Rudraksh91/SatelliteSoilMonitoring/ndvi_latest.jpeg

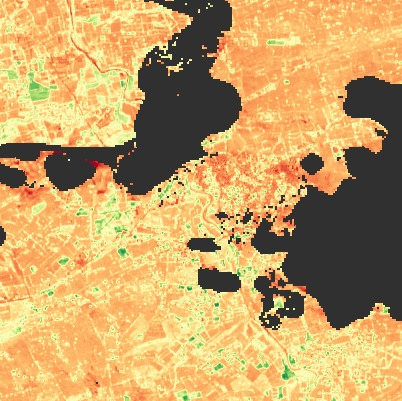
ndvi_latest.jpeg
