Rudraksh91/SatelliteSoilMonitoring/AgriSat_Flowchart.pdf

# ️ AgriSat Dediapada — System Architecture

# Satellite-Driven Autonomous Irrigation · Dediapada, Narmada, Gujarat

👥 ANY DEVICE — ANYWHERE

⚙️ macOS AUTOMATION

🌐 NETWORK / HOSTING

💾 STORAGE

🧠 app.py — Streamlit (port 8501)

📡 DATA SOURCES

Irrigation Decision Engine

Dashboard UI — 4 Tabs

ET₀ · Rain · Temp · Humidity | VWC % (SAR-derived)
No | Yes → irrigate
Every 30 min | Every 30 min

Auto-push rows

New URL on restart REST API PUT

Monitors

kickstart -k on failure

302 redirect | 302 redirect | 302 redirect

Served on :8501

Executes

Starts

Starts

Monitors

📱 Phone | 📟 Tablet | 💻 Browser

📜 run_agrisat.sh

Kill old processes cleanup trap on EXIT

Start Streamlit Wait for :8501

Start cloudflared Wait for tunnel URL | Wait 6s for stability Update Worker via REST API Save .tunnel_url + .permanent_url

🔄 launchd
com.agrisat.dediapada RunAtLoad · KeepAlive ThrottleInterval 15s Runs run_agrisat.sh

🩺 Daily Health Check
com.agrisat.healthcheck 9 AM every day 7 checks · Auto-restart on fail Mac notification on issue

☁️ Cloudflare Quick Tunnel cloudflared binary Random trycloudflare.com URL Changes on every restart

🔗 Cloudflare Worker Permanent URL agrisat-dediapada

.rudrakshpatel91.workers.dev 302 redirect → tunnel URL

📄 telemetry_log.csv Local file · Every 30 min All 3 fields per entry

📊 Google Sheets Auto-sync via Service Account agrisat-logger@…

Auto tab rotation at 50k rows

🏠 Dashboard
3 field cards · KPI gauge
Folium map · Radar chart | 📊 Live Data VWC trend · Charts Telemetry table · CSV download | ️ Data Sources Bhoonidhi auth Google Drive sync | ⚙️ Settings Crop · Area · Valve override
| | | Soil parameters

Soil VWC %
Satellite → Estimated fallback

VWC < 23%
refill point? Rain guard?

✅ Open Valve Duration = deficit ÷ drip rate ÷ efficiency Voice alert via speechSynthesis ⏸ Hold Valve Reason logged

️ ISRO EOS-04 SAR
Bhoonidhi API Soil Moisture VWC %

500m resolution · 6h cache

️ Open-Meteo API Temperature · Humidity Rainfall · ET₀ FAO-56

Free · No API key

02/06/2026, 09:49 | AgriSat — System Flowchart
file:///Users/rudrakshpatel/Desktop/SatelliteSoilMonitoring/flowchart.html | 1/1
