Rudraksh91/SatelliteSoilMonitoring/(commit log)

2026-06-08 TERRA-CORE AgriSat — initial deploy
    Satellite soil monitoring & smart irrigation dashboard.
    - Streamlit dashboard with NDVI, valve control, telemetry
    - ESP32 + LoRa field node firmware
    - Raspberry Pi brain (NDVI + AI decisions)
    - MQTT cloud bridge (HiveMQ)
    - PWA + Capacitor mobile app
2026-06-08 Add remaining project assets — docs, scripts, imported screens
2026-06-08 Add .nojekyll — disable Jekyll for GitHub Pages static deploy
2026-06-08 Fix PWA home-screen 404 — set correct GitHub Pages subpath in manifest + sw.js
    start_url and scope were "/" causing 404 when opened from home screen.
    Updated to "/SatelliteSoilMonitoring/" for GitHub Pages deployment.
    Bumped SW cache version to v1.1 to force old SW to update.
    [sw.js]
2026-06-09 fix: bump SW cache to v1.2 + switch HTML to network-first strategy
    Old cache-first strategy was serving the pre-Sentinel-1 index.html from
    agrisat-app-v1.1 on Mac browsers that had the SW installed, while phones
    without the cached SW fetched fresh from the network.
    Fix:
    - Bump APP_CACHE / CDN_CACHE to v1.2 (activate event nukes the v1.1 cache)
    - HTML navigation requests now use network-first so future deploys appear
    immediately without requiring another cache version bump
    - Static assets (icons, manifest) stay on cache-first for offline speed
    [sw.js]
2026-06-10 design: comprehensive UI refresh for TERRA-CORE AgriSat dashboard
    - Radial gradient body background (green + cyan ambient glows)
    - Glassmorphism .gp cards: gradient fill, depth shadow, hover lift
    - Upgraded header: gradient + strong backdrop-blur + green glow border
    - Upgraded sidebar: gradient fill, glowing eco logo icon, section divider
    - Upgraded footer: gradient fill, live status dot, consistent typography
    - nav-btn cursor:pointer + active green gradient + inset left border
    - KPI glow utilities (green/cyan/amber) applied to all key metrics
    - LIVE pill: rounded-full green-tinted + glowing dot indicator
    - 3px slim scrollbar with transparent track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
2026-06-10 design: round all card corners to 16px
    - .gp: border-radius 16px !important + overflow hidden (clips content to rounded shape)
    - Tailwind borderRadius scale bumped: DEFAULT→12px, lg→16px, xl→20px, 2xl→24px
    so every rounded / rounded-lg / rounded-xl utility class is also soft now
2026-06-10 feat: satellite loading screen after setup screen button tap
    - Animated SVG scene: Earth radar node with rotating sweep, 3 expanding
    signal rings, elliptical orbit with a detailed satellite (body + dual
    solar panels + blinking antenna + data-packet beam toward earth)
    - HUD overlays: corner brackets, ALT/INC/SAR/MODE data left, NDVI/SWATH/
    PASS/RES data right, signal-strength bars, satellite attribution footer
    - Smooth 3-second progress bar (rAF loop) + 6 cycling status messages
    (INITIALIZING → SATELLITE HANDSHAKE → NDVI STREAM → WEATHER → SENSORS → NOMINAL)
    - Both setup paths hooked: setupConnect success and setupSkip both call
    showSatLoader(); dashboard initialises in th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
2026-06-10 data: NDVI update 2026-06-10 — all zones STRESSED
    Auto-harvested by NDVIHarvester v2 at 11:29 IST.
    Sentinel-2 scene: 2026-05-26, cloud cover 1.1%.
    New Drive JPEG ID: 124jmxVN8sr8SSKMpwRketyVUlXRaDdMN
    Weather: ET0=2.39mm/d Rain3d=2.2mm VPD=0.68kPa
2026-06-10 feat: realistic Earth globe + detailed satellite in loading screen
    - Globe: deep ocean gradient, rotating continents (Africa, India, Asia,
    Europe, Americas, Antarctica, cloud streaks), lat/lon grid, atmosphere
    edge glow, night-side shadow, specular highlight
    - Satellite: gold thermal-blanket body with seam lines, multi-cell solar
    panels with gradients and grid lines, imaging aperture, star tracker,
    S-band dish, high-gain antenna boom, blinking LEDs, nadir signal beam
2026-06-10 Replace misleading "ACTIVE SENSORS: 6" with "SAR SATELLITES: 2"
    Project has zero ground sensors — soil data comes entirely from
    EOS-04 SAR and Sentinel-1 SAR imagery. Updated KPI card on the
    map page to accurately reflect the two satellite data sources.
2026-06-10 Fix crop dropdown clipped by overflow-hidden on valve cards
    Switched .crop-drop from position:absolute to position:fixed so it
    escapes the overflow:hidden on the valve zone cards. showCropDrop()
    now reads getBoundingClientRect() on the input and pins the dropdown
    to the exact screen coordinates, making the full list visible.
2026-06-10 Fix crop dropdown position — teleport to body to escape backdrop-filter
    backdrop-filter on .gp cards creates a new fixed-position containing
    block in Chromium, so position:fixed was offset by the card's position.
    Fix: on showCropDrop(), move the dropdown to <body> (via appendChild)
    so it is a direct child of the root and position:absolute with
    getBoundingClientRect()+scrollY gives the correct viewport coordinates,
    completely bypassing all backdrop-filter and overflow:hidden ancestors.
2026-06-11 Add dark/light theme switcher in Settings modal
    - Settings button in sidebar now opens a themed modal
    - Modal shows two preview cards: DARK (default Mission Control) and
    LIGHT (Field Mode) with mini visual previews
    - setTheme() / applyTheme() toggle body.theme-light class and persist
    choice to localStorage so it survives page reloads
    - Light theme CSS overrides: body gradient → soft green-white,
    .gp cards → frosted white glass, header/sidebar/footer → light tint,
    text/border/bg utility overrides for readability on light background
2026-06-11 Rebuild system flowchart to reflect current architecture
    Replace outdated Streamlit/Cloudflare flowchart with full TERRA-CORE
    styled 11-layer architecture diagram: EOS-04+Sentinel-1 satellites →
    NDVI Harvester → Google Drive → ndvi_status.json → Gemini AI →
    GitHub Pages PWA → Raspberry Pi → ESP32+LoRa gateway → 3 field
    ESP32 nodes → solenoid valves → Fields A/B/C (Dediapada).
    Pure HTML/CSS with glassmorphism cards, animated flow-dots, and
    TERRA-CORE dark green aesthetic (no Mermaid.js dependency).
2026-06-11 Add full responsive layout + auto screen rotation handling
    Breakpoints added:
    • Mobile landscape (height ≤ 500px, orientation:landscape) — compact
    48px header, 42px bottom nav with icons-only, shorter map strip
    • Tablet portrait (768–1023px) — 72px icon sidebar, all pages scroll
    vertically, page-specific grid adjustments (Map: 2-col card grid
    below map strip; NDVI/Auto stacked; Climate 3-col metric row;
    Health 2-col grid)
    • Tablet landscape / small laptop (1024–1279px) — reduced page
    padding, metric cards 3-col
    • Large desktop (≥ 1280px) — api-status bar always visible
    Other improvements:
    • viewport: allow pinch-zoom (max-scale:5) — was blocked by user-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
2026-06-11 Add comprehensive system technical report (report.html)
    6-section report covering the full TERRA-CORE AgriSat system:
    01 System Overview — sensor-free concept, 3-layer architecture, stats
    02 Hardware Wiring — animated SVG wiring diagram showing all connections
    (satellites → RPi → central ESP32+LoRa → 3 field ESP32s → relays →
    solenoid valves), pin-level tables for LoRa SPI wiring and relay
    wiring, RPi↔ESP32 connection options (USB Serial vs WiFi WebSocket)
    03 How It Works — 8-step annotated operation flow from satellite
    overpass to solenoid open, including Gemini AI water-balance formula
    04 Component Specs — full BOM with qty, specs, role, and cost (≈₹13,3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
2026-06-11 report: add equal-prominence author cards + 4 SVG diagrams
    - Replace stacked unequal author names with three side-by-side equal
    .author-card components (same size, same #00ff41 glow, same role)
    - FIG 1: 5-layer system architecture SVG (Space→Cloud→Hub→Field→Ground)
    - FIG 2: AI decision flowchart SVG with animated flow lines, rain guard
    and VWC threshold diamond decisions, IRRIGATE/HOLD outcomes
    - FIG 3: Dual bar chart SVG — water efficiency comparison (35/75/88%)
    and setup cost comparison (₹2k/₹80k/₹13.3k)
    - FIG 4: Gantt roadmap SVG — 6 phases across Q3 2026→2028 with animated
    bars, quarter markers, and a NOW marker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
2026-06-11 dashboard: switch UI fonts to Inter in light theme
    In dark mode JetBrains Mono fits the terminal aesthetic.
    In light mode it feels too heavy and technical — swap UI
    chrome (nav, toggles, tabs, dropdowns, labels, headings)
    to Inter for a clean, readable feel while keeping
    JetBrains Mono for live data readouts, the log stream,
    coordinates, NDVI/ET₀/VPD values, and code blocks.
2026-06-11 intro: add animated SVG robot to setup screen
    Inline SVG robot with TERRA-CORE green/cyan palette:
    - Blinking glowing eyes (green, animated)
    - Scanning mouth bar animation
    - Chest panel with 3 pulsing zone-indicator dots (green/cyan/gold)
    - Floating idle animation (translateY)
    - Claw hands, antenna with pulse
    - Drop-shadow glow effect
2026-06-12 intro: replace SVG robot with cute orange 3D-style waving robot
    Redesigned robot matches the reference image:
    - Round orange head with radial gradient shading
    - Silver headphone-style ear pieces with depth rings
    - Large round eyes with dark pupils, glass highlight dots,
    and blinking eyelid animation
    - Curved smile
    - Waving right arm (CSS rotate animation, pivot at shoulder)
    - Left arm gentle swing
    - Blue teal chest gem
    - Rounded orange legs and feet
    - Full body float up/down animation
    - Ground shadow that scales with the float
2026-06-12 intro: replace robot with animated Terra-Core satellite logo
    - Floating satellite (bobs up/down, 3s loop)
    - Spinning orbit ring with glowing marker dot (12s loop)
    - Pulsing SAR radar beams pointing to ground (staggered)
    - Pulsing center dot on satellite body
    - Bouncing moisture droplets below ground line
    - TERRA / CORE text preserved from the icon
    - Matches icon.svg exactly, scaled to 200×200 on screen
2026-06-12 intro: replace Terra-Core logo with animated RRM logo
    Recreates the RRM logo as inline SVG matching the reference image:
    - Dark navy blue orbit arc (~270°) going over the top
    - Navy satellite with solar panel grids, dish antenna
    - Pulsing signal waves from dish (3 staggered arcs)
    - Farm terrain: 3 undulating green bands with crosshatch grid
    - Bold italic RRM text: dark green R, bright green R, dark green M
    - Lower green arc closing the circle
    - Wheat stalk (right), seedling plant (center), grass blades (left)
    Animations:
    - Satellite floats up/down (3s)
    - Signal waves pulse in/out (staggered 0/0.3/0.6s)
    - Wheat, plant, grass all sway (2.7–3.5s)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
2026-07-08 website: make system log event-driven instead of scripted
    pushLog()/pushTerm() previously cycled fixed message arrays on a timer
    regardless of actual state, mostly only ever mentioning Field A, and
    included fictional events with no real backing in this codebase
    (GEMINI_INFERENCE, HANDSHAKE_SUCCESS::NODE_774). Now logs only fire on
    real state transitions using the same rule engine as the timeline:
    valve open/close, ET0 boost, and a single farm-wide RAIN_GUARD line
    (weather is one shared Open-Meteo reading, not per-field). Sensor-read
    heartbeat rotates fairly across all 3 fields, and sync lines only fire
    on genuine successful fetchWeather()/NDVI-poll events.
2026-07-08 website: fix rain-guard lockout window and unify soil VWC across fields
    rainGuardActive() previously only checked the current hour's rain/forecast,
    so a heavy overnight rain event (verified: 13.7mm/hr ~29h prior) stopped
    suspending irrigation as soon as that hour passed. Added past_days=2 to
    the Open-Meteo call and a 48h post-rain hold plus a 24h forward-looking
    check (>=10mm forecast), so the rulebook's rain rule actually matches
    its stated intent instead of just instantaneous conditions.
    Also unified S.vA/vB/vC to one shared farm-wide VWC value (kept as 3
    synced properties so existing per-field UI didn't need touching) instead
    of independent random-walk simulations — there's no real per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
2026-07-08 website: make AUTO_OPT panel functional
    The 3 toggles (DRIP_CONTROL_A/ET0_COMPENSATION/RAIN_GUARD_MODE) and the
    DEPLOY_CHANGES button were static markup with no handlers. Now clicking
    a toggle stages a change (Deploy button shows a "*" until applied), and
    deploying rewires the actual automation: RAIN_GUARD_MODE gates
    rainGuardActive() entirely, ET0_COMPENSATION gates the ET0_ADJUST boost,
    and DRIP_CONTROL_A forces Field A into a MANUAL_OVERRIDE state bypassing
    auto-irrigation. Settings persist across reloads via localStorage and
    deploying logs a real confirmation event.
2026-07-08 website: don't report trace rain readings as "actively raining"
    rainGuardActive() treated any S.rain_mm>0 as active rainfall, so a 0.1mm
    trace/noise reading got reported as "ACTIVE RAINFALL" even when it wasn't
    really raining. Added RAIN_ACTIVE_MIN_MM=1 threshold so only genuine rain
    counts as "raining now" — the 48h post-rain hold (already correct) still
    applies independently when warranted, but the displayed reason no longer
    misattributes it to current rain that isn't actually happening.
2026-07-09 website: clarify Google Earth Engine as the pipeline's actual data source
    EOS-04/RISAT-1A stays planned/not-wired; GEE's subtitle and detail copy
    now make clear it's the real, accurate imagery source in the meantime.
2026-07-09 website: restyle data pipeline diagram as a technical schematic
    Sharp corners, grid background, sheet border with corner registration
    marks, a blueprint-style title block, dimension-line connectors, and
    component ID tags (01A-05C) replace the neon/glow look for a more
    scientific, engineering-drawing feel. Legend moved into a bordered key panel.
2026-07-09 website: animate pipeline detail panel open/close
    Node clicks and the back button now cross-fade with a slight slide
    instead of snapping between the tree and detail views instantly.
2026-07-09 website: animate page transitions across the whole app
    Every nav() tab switch (Map, Analytics, Climate, Auto, Health,
    Pipeline) now fades/slides/scales the new page in instead of
    snapping instantly, via a restartable CSS keyframe animation.
2026-07-09 website: replay chart draw-in animation on every tab switch
    switchWeatherTab() now calls chart.reset() + chart.update() after
    resize, so each weather chart redraws itself from scratch whenever
    you switch to its tab instead of only animating once on first load.
2026-07-09 app: wire real satellite NDVI into per-field irrigation logic
    Field cards previously all showed the same weather-estimated VWC with
    no per-zone differentiation, even though the NDVI harvester already
    produces real per-zone ground truth in ndvi_status.json. decide() now
    takes that data and overrides a "hold" call with a light irrigation
    pulse when a zone shows genuine satellite-observed stress; field cards
    and a new satellite-pass panel surface the NDVI value, health tier,
    and scene freshness per zone.
    Also removes dead code (unused imports, a duplicate variable) and two
    orphaned asset folders (static/, imported/) that nothing referenced.
2026-07-11 fix: enable rulebook editor + serve NDVI image from GitHub instead of Drive
    Rulebook cards were static HTML with no handlers — wire them to a
    localStorage-backed CRUD (add/edit/delete/toggle) via a new rule modal.
    The NDVI image was invisible because Google Drive's public links
    (both uc?export=view and thumbnail) send
    Cross-Origin-Resource-Policy: same-site, which Chrome uses to ORB-block
    <img> hotlinking from a different origin. Host the JPEG in this repo
    instead (ndvi_latest.jpeg, served via raw.githubusercontent.com like
    ndvi_status.json already is) and point jpeg_url there.
    Also replaces the last of the random/simulated soil VWC drift with a
    real FAO-56 water-balance model driven by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
2026-07-11 fix: remove fabricated stats/integrations, correct satellite mislabeling
    Several dashboard cards asserted things that aren't true anywhere in the
    codebase — no real backing data or integration exists for any of them:
    - "GEMINI AI MODEL" / "GENAI v2 SDK" / 91% "AI efficiency" — no Gemini/GenAI
    call exists anywhere; irrigation logic is the deterministic FAO-56 water
    balance + rule engine. Replaced with a real stat: enabled/total rule count
    from the (now-functional) Rulebook editor.
    - "STITCH MCP: CONNECTED" — no such integration exists. Replaced with a real
    GitHub Pages/raw.githubusercontent.com status card.
    - "SAR SATELLITES: 2 · EOS-04 · S-1" — EOS-04 is explicitly "PLANNED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
2026-07-13 feat: replace dark/light theme picker in Settings with Force Refresh
    Remove the unused theme-switching system (settings UI, applyTheme/
    setTheme JS, and the theme-light CSS block) and add a Data & Cache
    section with a Force Refresh button that clears the service worker
    cache and reloads, so the app always shows the latest deployed build.
2026-07-14 fix: wire Smart Logic Rulebook into the actual irrigation Timeline engine
    The Rulebook editor was cosmetic — editing the VWC drip rule only updated
    localStorage/log text, while evaluateFieldAction() and the tickVWC water
    balance sim used hardcoded 20%/23% thresholds regardless of what the rule said.
    Now the enabled "OPEN DRIP VALVE" rule's VWC% is read live, so editing it in
    the UI actually changes when the drip fires.
2026-07-14 feat: add Gujarat-local crop filter to Manual Mode crop search
    Tags 33 existing crops (wheat, bajra, jowar, cotton, groundnut, castor,
    cumin, etc.) plus 2 new ones (Sapota, Isabgol) as locally grown in
    Gujarat, and adds a per-valve GUJARAT toggle chip that narrows the
    300-crop global search down to just those, so farmers don't have to
    hunt through unrelated crops (Ginseng, Feijoa, Quinoa...) to find local ones.
2026-07-14 fix: default the Rulebook drip threshold to 30% VWC, migrate stale 20%
    The drip rule previously defaulted to 20%, which only mattered once the
    Rulebook was wired to the live Timeline engine — before that it was
    cosmetic, so no one could have deliberately chosen 20%. Bumps
    RULES_DEFAULT to 30% for new devices, and adds a one-time migration
    that upgrades any already-saved 20% (this device included) to 30%
    without touching a rule the user genuinely edited afterward. Also adds
    a 30% quick-pick chip in the rule editor.
2026-07-15 feat: control the Pi's real solenoid valve + show live Pi brain status in app.py
    - app.py now drives a real relay on GPIO23 (active-low) when the
    Open/Close Valve buttons are pressed, in addition to the existing
    FAO-56 simulation — the buttons work from any phone via the public
    dashboard URL now that the app runs on the Pi itself. GPIO setup is
    wrapped in st.cache_resource since Streamlit re-runs the whole script
    per interaction and would otherwise re-claim (and briefly drop) the
    pin on every rerun.
    - Added a real "PI BRAIN ONLINE/OFFLINE" header badge, driven by
    `systemctl is-active agrisat-brain` — reflects the actual brain.py
    systemd service state, not a fabricated sta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
2026-07-15 fix: resolve GPIO ownership conflict, sync real valve state, add rain guard
    - brain.py is now the single owner of the physical relay's GPIO23 — app.py
    was claiming the same pin directly from a separate process, which would
    fight brain.py for the line. app.py now publishes an MQTT command instead
    (same message the website's Cloud MQTT panel already sends), so there's
    one authoritative hardware owner regardless of which UI issued the command.
    - Fixed a real GPIO claim bug in brain.py: SX127x's BOARD.setup() calls
    GPIO.setmode() again for the LoRa pins, which resets lgpio's internal chip
    handle and silently drops any claim made before it. Moved the valve's
    GPIO.setup() to run af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
    [app.py, brain.py]
2026-07-15 fix: switching to Manual Mode no longer auto-reverts to Auto
    setIrrigMode() never told brain.py about the mode change, so brain's own
    auto_mode flag stayed stuck at its default True. Every ~3s publish then
    reported auto_mode:true, and the dashboard's state-sync logic saw a
    mismatch against the just-selected Manual mode and forced it back to Auto.
    Now setIrrigMode() sends the real auto_mode over MQTT/WebSocket. That
    alone caused a second race — a stale publish generated before brain.py
    processed our command could still bounce the UI back within one cycle —
    so incoming valve/auto_mode sync corrections are now skipped for 4s after
    any command we just sent (_lastHwCmdTime), enough to cover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
2026-07-15 feat: show cloud drift / sun / moon animation on the Map page
    Adds a real-data-driven sky visual next to the rain effect: drifting
    cloud blobs when Open-Meteo's cloud_cover crosses 45%, otherwise a sun
    or moon icon depending on is_day — mutually exclusive, matching what
    you'd actually see looking up. Both values were already being fetched
    for the Cloud Layers chart but never wired to the map itself.
2026-07-15 fix: make the Map page cloud effect actually visible
    The cloud/sun/moon feature committed earlier (8909998) was correctly
    wired to real cloud_cover/is_day data but the blobs were invisible in
    practice: heavy blur + a fade-to-transparent gradient made them too
    faint against the satellite imagery. Simplified to a flat semi-opaque
    fill with a moderate blur (softens hard edges without vanishing), and
    gave #map-cloud-fx/#map-sky-icon explicit z-index so they don't depend
    on ambiguous stacking order against the Leaflet container. Verified
    visually across cloudy/clear-day/clear-night states.
2026-07-15 fix: make the Map page cloud effect actually visible
    Traced the earlier "can't see the map" report to #map-cloud-fx nested
    inside the 3D-transformed #map-3d-wrap: an overflow/box-shadow-bearing
    layer inside a rotateX-transformed ancestor produced a hard rendering
    seam across the map (browser 3D-compositing quirk, confirmed by
    isolating each sibling layer — removing overflow:hidden alone did not
    fix it). Moved #map-cloud-fx and #map-sky-icon out to a flat sibling
    layer at the same screen position instead of sharing the tilt — clouds
    now render correctly, floating above the tilted terrain rather than
    being glued to its plane, which reads fine physically. Also tuned the
    tilt to a gentler ro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
2026-07-15 fix: detect a dead Pi/ESP32 even while the MQTT/WS socket stays "connected"
    The HW panel's CONNECTED status only reflected the browser's own link to
    the HiveMQ broker (or ESP32 WebSocket) — that link stays up indefinitely
    even after the actual device goes offline, since MQTT subscribers have
    no built-in signal that a publisher stopped publishing. Added a
    staleness watchdog: track when real data last arrived, and if brain.py's
    ~3s publish cadence goes quiet for 12s+, downgrade the badge to an
    orange "NO DATA — DEVICE OFFLINE?" instead of a misleading green
    CONNECTED. Flips back automatically once data resumes.
2026-07-16 fix: auto-drip runs a fixed 1.5h cycle instead of flickering continuously
    evaluateFieldAction() previously computed "DRIP CYCLE ACTIVE" as a pure
    function of the current VWC vs threshold, re-evaluated on every tick with
    no memory — so it would flip on/off continuously as VWC crossed the line
    instead of ever settling, and never actually stopped for a bounded,
    predictable duration. Added isFieldDripping(), shared by the Timeline
    display and tickVWC's replenishment model: once a field crosses below
    threshold it locks into a fixed AUTO_DRIP_HOURS=1.5 window, stays active
    even if VWC recovers mid-cycle, and only re-evaluates against the
    threshold once that window expires.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
2026-07-16 fix: explain why Manual Mode's Open Valve does nothing during rain guard
    openValve() was correctly blocking real valve opens during active rain
    guard (working as designed), but gave zero visible feedback beyond a
    log-stream entry that gets pushed out within ~1 minute by heartbeat
    spam (12-entry cap, new entry every 6s) — so it just looked like the
    button silently didn't work. Added a persistent banner on the Manual
    Mode panel that shows the live rain-guard reason whenever it's actually
    blocking opens, updated on every 6s refresh and immediately on
    switching into Manual Mode.
2026-07-16 fix: correct solenoid valve GPIO polarity, compensate at website layer
    Relay is active-high (confirmed on the FILMAX 12V solenoid + relay
    board, NO wiring verified correct), not active-low as originally
    assumed — flip GPIO HIGH/LOW mapping in brain.py and test_valve.py.
    Also flip the outgoing hw command in index.html's Manual Mode
    open/closeValve as a stopgap, since the Pi's brain.py service hasn't
    been redeployed/restarted with the polarity fix yet. Dashboard UI
    still displays the correct logical state — only the wire command is
    inverted. Revert this once brain.py's fix is live on the Pi.
    [brain.py, test_valve.py]
2026-07-16 fix: stop valve echo-sync feedback loop with the Pi's single relay
    brain.py has only one physical relay right now but mirrors that single
    boolean across all 3 zone slots in its published state. The dashboard's
    "another device may have changed them" sync logic treated each zone as
    independently reportable, so opening one zone made the Pi's echo look
    like zones 2/3 had also changed — triggering real openValve/closeValve
    HW commands for them, changing the shared relay again, forever. Also
    reverts the earlier GPIO-polarity stopgap flip now that brain.py's own
    fix is live on the Pi.
2026-07-16 fix: add Settings entry to top header — mobile had no way to reach it
    The only Settings button lived in the sidebar (hidden md:flex), and the
    mobile bottom nav never had a Settings entry either. Phone users had no
    way to open Settings → FORCE REFRESH to clear a stale cached build.
2026-07-17 fix: unify app icon with splash logo, fix stray-leaf rendering bug
    icons/icon.svg (favicon/apple-touch-icon/PWA icon) was a completely
    different design from the animated RRM satellite logo shown on the
    splash screen — replaced it with a static version of the same artwork
    so branding is consistent everywhere, and pointed the always-visible
    sidebar logo at it too (was a generic Material Symbols "eco" glyph).
    Also found and fixed a real bug while doing this: the wheat/plant/leaf
    sway animations used transform-box:fill-box on <g> elements, which
    renders inconsistently across engines and was flinging those groups
    outside the 512x512 canvas — visible as a stray leaf poking out the
    top-left co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
2026-07-17 feat: push-notification alarms for too-much-rain / too-dry conditions
    Adds a phone/laptop alarm system via ntfy.sh (free, no account) that
    fires on the exact same thresholds Rain Guard and the VWC critical
    alert already use — no new numeric cutoffs. "Too much rain" triggers
    on active rainfall or a heavy 24h forecast (RAIN_ACTIVE_MIN_MM /
    RAIN_FORECAST_24H_MM); "too dry" triggers on the existing VWC<20%
    CRITICAL cutoff. Re-notifies at most every 6h while a condition
    persists, cleared automatically once it resolves.
    Settings modal gets a toggle, the ntfy topic name, and a test-alert
    button. Caught and fixed a real bug during testing: HTTP header
    values must be Latin-1, so emoji/em-dash in t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
2026-07-17 fix: HW status stuck on CONNECTED when Pi was off before the browser connected
    The staleness watchdog only started measuring quiet-time from
    _lastDataAt, and skipped entirely while it was still 0 ("never
    received anything yet — let the initial connect message stand"). That
    early-return was meant for the first few seconds after a fresh
    connect, but if the Pi/ESP32 was already powered off when the browser
    connected to the broker, _lastDataAt stays 0 forever — so the watchdog
    deferred permanently and the HW pill stayed green/CONNECTED
    indefinitely despite zero real data ever arriving.
    Added _brokerConnectedAt, set when the WS/MQTT socket itself comes up,
    and use it as the staleness baselin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
2026-07-17 feat: macOS-style window chrome — traffic lights, spring sheets, Dock magnification
    Settings and Hardware Connection modals get real macOS window chrome:
    - Red/yellow/green traffic-light dots replace the plain ✕ button (red
    closes; yellow/green are decorative — no minimize/maximize exists to
    wire them to, yellow gets a playful wiggle instead of pretending to
    do something).
    - Modals now open/close with a spring-based scale+fade (overshoot
    cubic-bezier, classic macOS sheet "pop") instead of an instant
    display:none/block snap. Display is still toggled so the backdrop
    doesn't eat clicks while hidden — just staged around the transition
    via new openMacSheet()/closeMacSheet()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
2026-07-17 fix: Analytics/Climate pages rendered simultaneously with the active page on tablet portrait
    Audited responsive behavior across iPhone, Android, iPad (portrait +
    landscape), and desktop widths. Found a real bug in the 768–1023px
    tablet-portrait media query: #page-ndvi and #page-climate had
    display:flex!important WITHOUT the .active qualifier every other page
    rule uses. Since an ID selector beats the base .page{display:none!important}
    class rule regardless of !important tie-breaking, both pages rendered
    at all times on tablets in this width range — stacked on top of
    whichever page was actually active (e.g. opening the Auto tab showed
    Auto controls bleeding through the Climate chart and An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
2026-07-17 feat: cinematic welcome screen — starfield, spotlight glow, staggered reveal
    The welcome/setup screen previously rendered all at once with no
    sequencing. Now:
    - A slowly drifting starfield (pure CSS radial-gradient dots, no JS/
    canvas) fades in behind everything.
    - A soft breathing spotlight glow sits behind the RRM logo.
    - A radial vignette darkens the edges for depth.
    - Every element (icon, title, subtitle, divider, logo, description,
    input, buttons, footnote) fades up in sequence with staggered
    delays instead of appearing simultaneously.
    - The TERRA-CORE title gets a one-shot diagonal light-sweep across
    the text after it settles, like a lens flare catching chrome.
    - Respects pre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
2026-07-17 feat: add floating astronaut and ringed planet to the welcome screen
    Extends the cinematic welcome screen with two hand-drawn SVG space
    elements: a waving astronaut (upper-right) that tumbles gently in a
    slow zero-gravity drift, and a small ringed planet (lower-left) with
    a much slower parallax drift. Both fade in as part of the existing
    staggered reveal, use the app's brand green/cyan for accent details
    (visor sheen, chest panel lights, orbit ring), and respect
    prefers-reduced-motion.
    Added a mobile-specific size/position override (≤480px) — at full
    size the astronaut overlapped the AGRISAT DEDIAPADA subtitle and the
    planet touched the Skip button on narrow phones.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
2026-07-18 revert: bring back the hand-drawn SVG astronaut on the welcome screen
    Reverting the NASA photo swap — back to the original illustrated
    astronaut (waving, green-visor sheen, brand-color chest panel).
2026-07-25 hide scene date label on NDVI heatmap panel
